archieross/Cocktail-Machine/README.md

University of Bath first year Arduino project: winning 'Most likely to be adopted by the student community.'

My team created a functioning cocktail machine using milk pumps and relays that allowed users to enter coins to get drinks.

A demo of the project can be found in the following YouTube video: 

IMAGE ALT TEXT HERE (https://www.youtube.com/watch?v=l0t5V1xgKGM)
